nathmo/velion_lightboard_pcb/velion_lightboard_pcb (Mouser).xlsx

Reference | Qty | Value | DNP | Exclude from BOM | Exclude from Board | Datasheet | Original Part | Original Manufacturer | Matched Part Number | Part Match | Description | Qty | Selected Offers | Selected Distributor | Selected Distributor SKU | Selected Offers (Distributor Link) | Stock | Unit Price, $ | Total Quantity | Total Price
C0, C1, C2, C3, C4, C5, C6, C7, C8, C9, C10, C11, C12, C13, C14, C15, C16, C17, C18 | 19 | 100nF |  |  |  | ~ | 100nF |  | 1206B104K101CT | Selected | 1026 0.1 uF 100 V ±10 % Tolerance X7R SMT Multilayer Ceramic Capacitor | 76 | Mouser 791-1206B104K101CT (https://octopart.com/opatz8j6/a1) | Mouser | 791-1206B104K101CT (https://octopart.com/opatz8j6/a1) | https://octopart.com/opatz8j6/a1 | 8900 | 0.037 | 76 | 2.81
C19, C20, C21 | 3 | 1nF |  |  |  | ~ | 1nF |  | 1206B102K101CT | Selected | Multilayer Ceramic Capacitor, 1000 Pf, 10%, X7R, 100 V, 1206 | 12 | Mouser 791-1206B102K101CT (https://octopart.com/opatz8j6/a1) | Mouser | 791-1206B102K101CT (https://octopart.com/opatz8j6/a1) | https://octopart.com/opatz8j6/a1 | 56940 | 0.048 | 12 | 0.576
D0 | 1 | US1M |  |  |  | https://www.diodes.com/assets/Datasheets/ds16008.pdf | US1M |  | S1M-13-F | Selected | Rectifier Standard Recovery Gpp Sma 1.0A 1000V Rohs 5K Rohs Compliant: Yes | 4 | Mouser 621-S1M-F (https://octopart.com/opatz8j6/a1) | Mouser | 621-S1M-F (https://octopart.com/opatz8j6/a1) | https://octopart.com/opatz8j6/a1 | 300733 | 0.19 | 4 | 0.76
D2, D3, D6, D7, D9, D10 | 6 | RB551V-30-HF |  |  |  | ~ | RB551V-30-HF |  | RB551V-30-HF | Selected | Rectifier Diode, Schottky, 1 Phase, 1 Element, 0.5A, 30V V(RRM), Silicon | 24 | Mouser 750-RB551V-30-HF (https://octopart.com/opatz8j6/a1) | Mouser | 750-RB551V-30-HF (https://octopart.com/opatz8j6/a1) | https://octopart.com/opatz8j6/a1 | 3602 | 0.283 | 24 | 6.79
D4, D5, D8, D11, D12, D13 | 6 | D |  |  |  | ~ | D |  | S1M-13-F | Selected | Rectifier Standard Recovery Gpp Sma 1.0A 1000V Rohs 5K Rohs Compliant: Yes | 24 | Mouser 621-S1M-F (https://octopart.com/opatz8j6/a1) | Mouser | 621-S1M-F (https://octopart.com/opatz8j6/a1) | https://octopart.com/opatz8j6/a1 | 300733 | 0.111 | 24 | 2.66
Q0, Q5, Q6, Q11, Q12, Q17, Q18, Q19 | 8 | NMOS |  |  |  | ~ | NMOS |  | IRFML8244TRPBF | Selected | MOSFET N-CH 25V 5.8A SOT23 N-Channel 25 V 5.8A (Ta) 1.25W (Ta) Surface Mount SOT-23 | 32 | Mouser 942-IRFML8244TRPBF (https://octopart.com/opatz8j6/a1) | Mouser | 942-IRFML8244TRPBF (https://octopart.com/opatz8j6/a1) | https://octopart.com/opatz8j6/a1 | 1868 | 0.14 | 32 | 4.48
Q1, Q2, Q3, Q4, Q7, Q8, Q9, Q10, Q13, Q14, Q15, Q16 | 12 | BSS123-7-F |  |  |  | ~ | BSS123-7-F |  | BSS123-7-F | Selected | Transistor: N-MOSFET; unipolar; 100V; 170mA; 6ohm; 300mW; -55+150 deg.C; SMD; SOT23 | 48 | Mouser 621-BSS123-F (https://octopart.com/opatz8j6/a1) | Mouser | 621-BSS123-F (https://octopart.com/opatz8j6/a1) | https://octopart.com/opatz8j6/a1 | 87940 | 0.139 | 48 | 6.67
R1, R13, R15, R26, R27, R36, R38, R45 | 8 | 0.001 R |  |  |  | ~ | 0.001 R |  | CSNL2512FT1L00 | Selected | Res Metal Foil 2512 0.001 Ohm 1% 2W ±50ppm/C Pad SMD Automotive T/R | 32 | Mouser 708-CSNL2512FT1L00 (https://octopart.com/opatz8j6/a1) | Mouser | 708-CSNL2512FT1L00 (https://octopart.com/opatz8j6/a1) | https://octopart.com/opatz8j6/a1 | 19878 | 0.361 | 32 | 11.55
U2 | 1 | MCP23017_SO |  |  |  | https://ww1.microchip.com/downloads/aemDocuments/documents/APID/ProductDocuments/DataSheets/MCP23017-Data-Sheet-DS20001952.pdf | MCP23017_SO |  | MCP23017T-E/SO | Selected | MCP23017 Series 5.5 V 1.7 MHz SMT 16-Bit I2C I/O Expander - SOIC-28 | 4 | Mouser 579-MCP23017T-E/SO (https://octopart.com/opatz8j6/a1) | Mouser | 579-MCP23017T-E/SO (https://octopart.com/opatz8j6/a1) | https://octopart.com/opatz8j6/a1 | 12638 | 1.62 | 4 | 6.48
U3, U4, U9, U11, U12, U13 | 6 | LM2104DR |  |  |  |  | LM2104DR |  | LM2104DR | Selected | "107-V, 0.5-A/0.8-A HALF-BRIDGE G" Half-Bridge Gate Driver IC Inverting 8-SOIC | 24 | Mouser 595-LM2104DR (https://octopart.com/opatz8j6/a1) | Mouser | 595-LM2104DR (https://octopart.com/opatz8j6/a1) | https://octopart.com/opatz8j6/a1 | 3412 | 0.566 | 24 | 13.58
U5, U7, U10 | 3 | MCP6L01x-xOT |  |  |  | http://ww1.microchip.com/downloads/en/devicedoc/22140b.pdf | MCP6L01x-xOT |  | MCP6L01T-E/OT | Selected | IC OPAMP GP 1 CIRCUIT SOT23-5 General Purpose Amplifier 1 Circuit Rail-to-Rail SOT-23-5 | 12 | Mouser 579-MCP6L01T-E/OT (https://octopart.com/opatz8j6/a1) | Mouser | 579-MCP6L01T-E/OT (https://octopart.com/opatz8j6/a1) | https://octopart.com/opatz8j6/a1 | 131977 | 0.32 | 12 | 3.84
U6, U14 | 2 | ADS1115IDGS |  |  |  | http://www.ti.com/lit/ds/symlink/ads1113.pdf | ADS1115IDGS |  | ADS1115IDGST | Selected | Quad Channel Single ADC Delta-Sigma 860sps 16-bit Serial 10-Pin VSSOP T/R | 8 | Mouser 595-ADS1115IDGST (https://octopart.com/opatz8j6/a1) | Mouser | 595-ADS1115IDGST (https://octopart.com/opatz8j6/a1) | https://octopart.com/opatz8j6/a1 | 4418 | 4.83 | 10 | 48.3
U8 | 1 | TJA1051T-3 |  |  |  | http://www.nxp.com/docs/en/data-sheet/TJA1051.pdf | TJA1051T-3 |  | TJA1051T/3/2Z | Selected | CAN Interface, CAN Transceiver, I2C, 5 Mbps, 4.5 V, 5.5 V, SOIC, 8 Pins | 4 | Mouser 771-TJA1051T/3/2Z (https://octopart.com/opatz8j6/a1) | Mouser | 771-TJA1051T/3/2Z (https://octopart.com/opatz8j6/a1) | https://octopart.com/opatz8j6/a1 | 3444 | 1.22 | 4 | 4.88
