nathmo/velion_lightboard_pcb/velion_lightboard_pcb.step

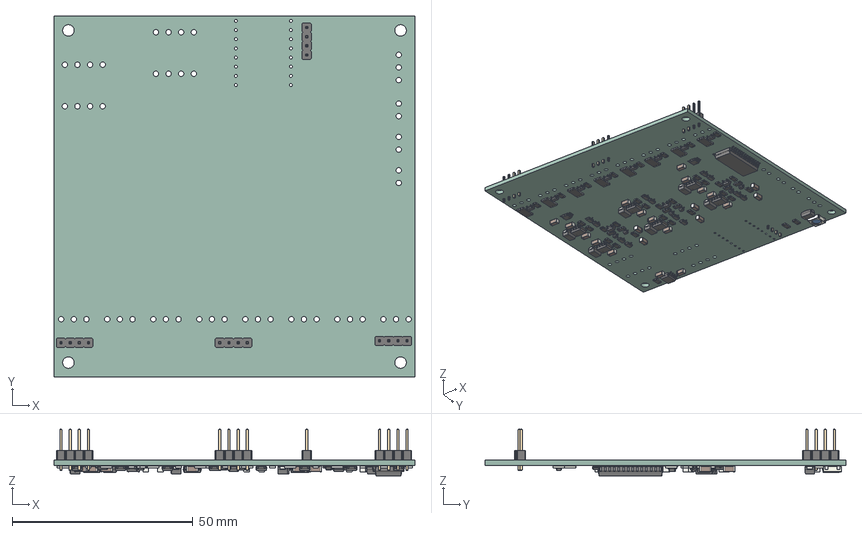
[picture p1: CAD file, 2026-01-05]
velion_lightboard_pcb.step
100.0 x 100.0 x 13.0 mm
PinHeader_1x04_P2.54mm_Vertical x 4
TSSOP-10_3x3mm_P0.5mm x 2
D_SOD-323 x 6
C_1206_3216Metric x 22
SOT-23 x 8
TSOT-23 x 12
SOT-23-5 x 3
D_SMA x 7
R_1206_3216Metric x 38
SO-8_3.9x4.9mm_P1.27mm x 6
R_2512_6332Metric x 8
SOIC-8_3.9x4.9mm_P1.27mm
SOIC-28W_7.5x17.9mm_P1.27mm
LED_WS2812B_PLCC4_5.0x5.0mm_P3.2mm
velion_lightboard_pcb_PCB
