nathmo/velion_lightboard_pcb/exports/velion_lightboard_pcb_schematic.pdf

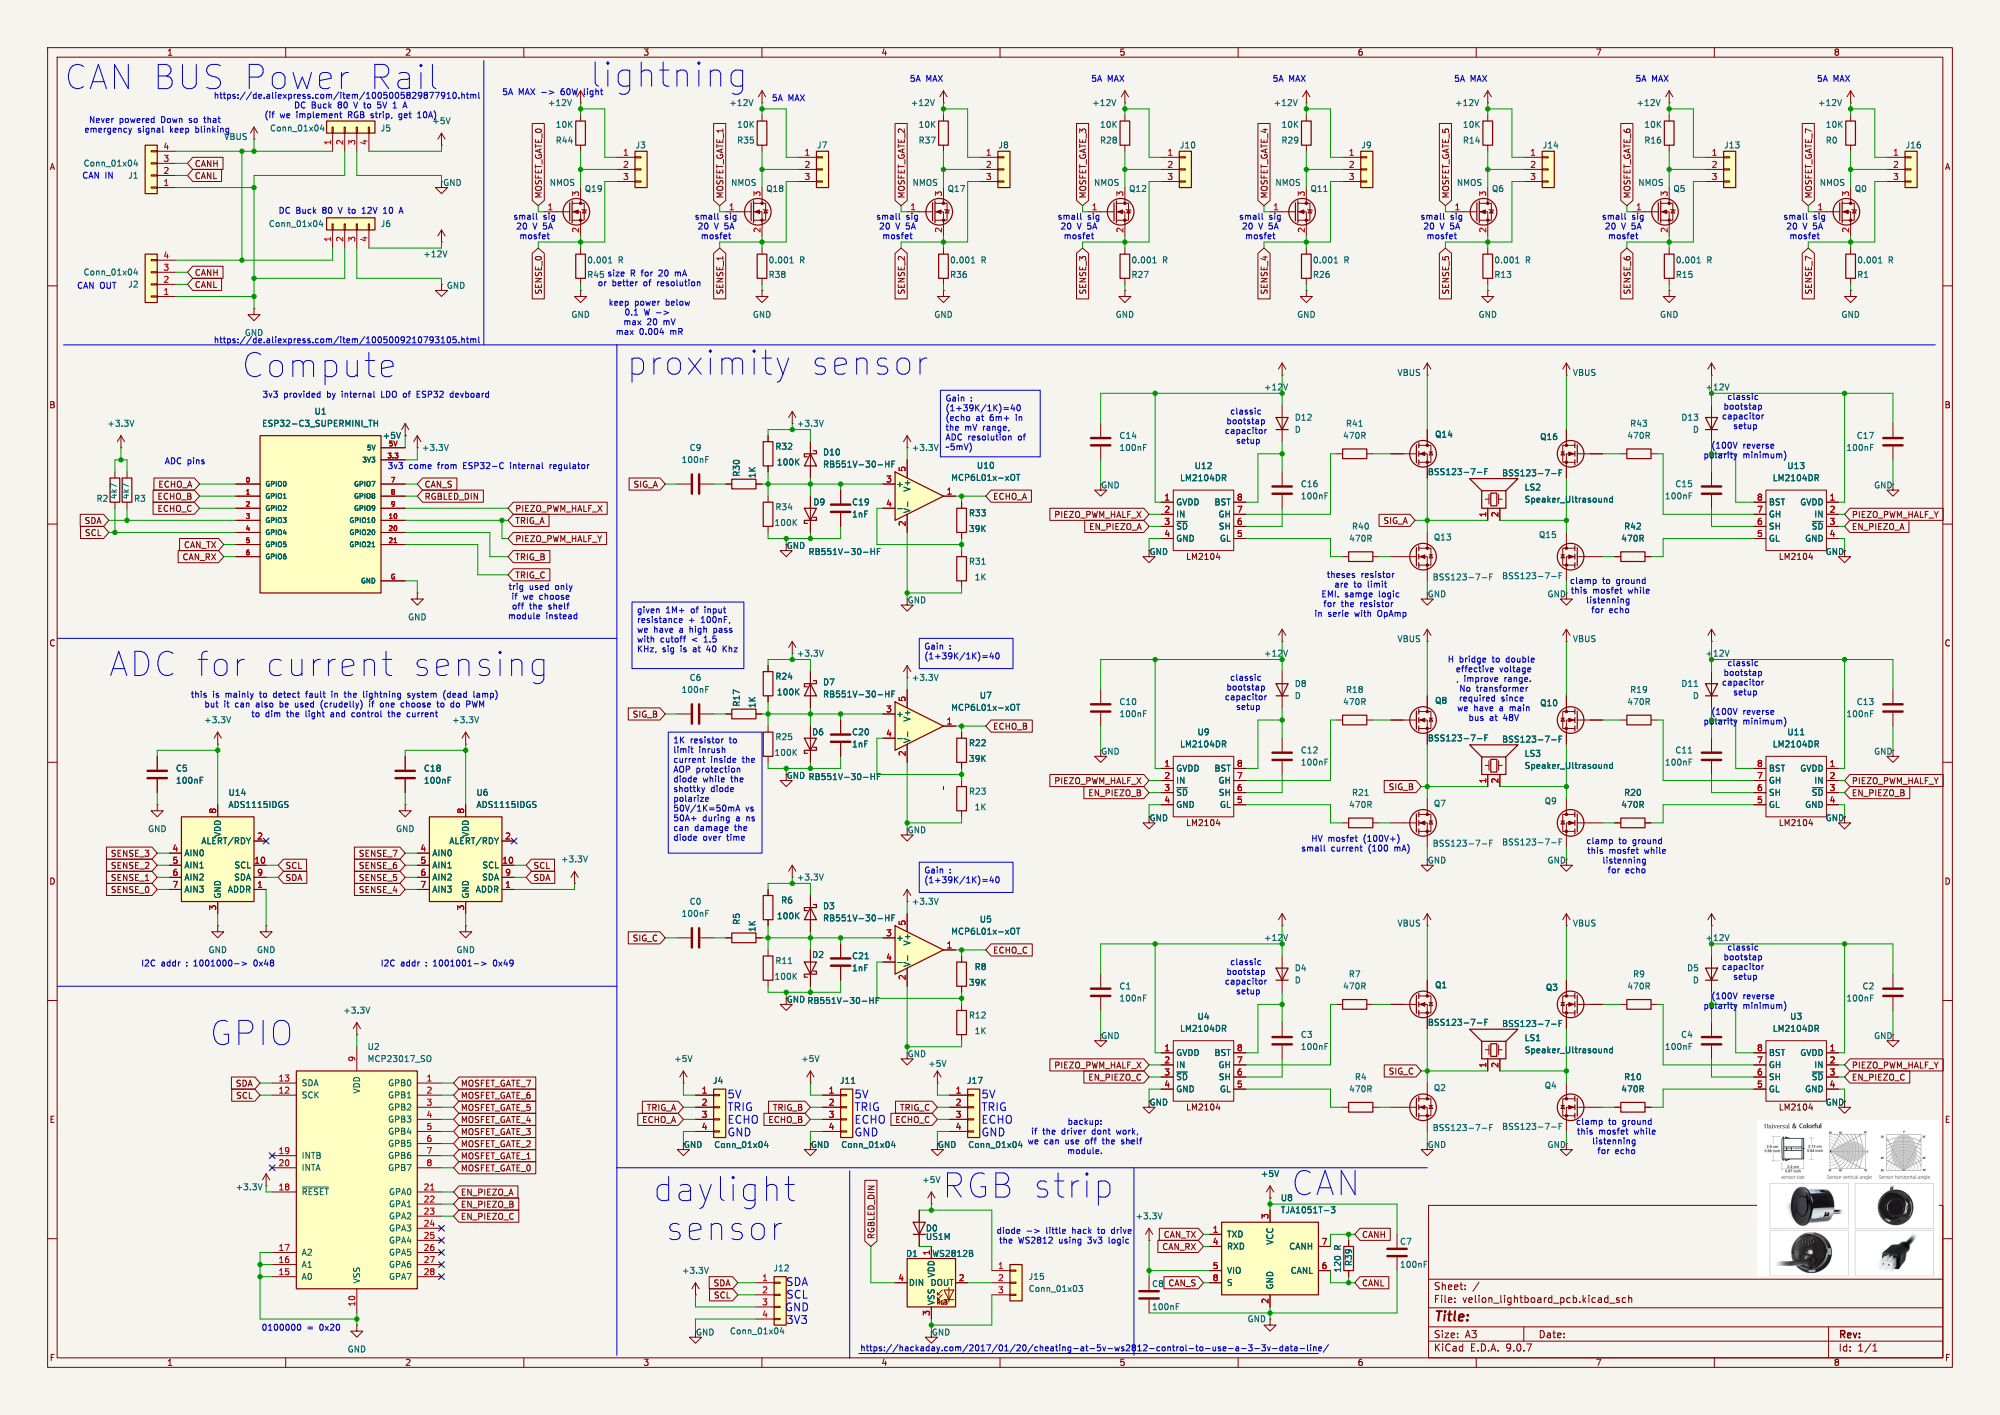
[picture p2: page 1]

CAN BUS Power Rail

4 Conn_01x04 J5
ADC pins CAN IN

keep power below
0.1 W -> max 20 mV max 0.004 mR

https://de.aliexpress.com/item/1005009210793105.html

TRIG_C
trig used only
if we choose
off the shelf module instead

theses resistor are to limit EMI. samge logic

for the resistor
in serie with OpAmp

, improve range. No transformer

limit inrush
current inside the AOP protection

3 ALERT/RDY 2 SCL 10 SDA 9 ADDR 1 C18

3 ALERT/RDY 2 SCL 10 SDA 9 ADDR 1 U14 ADS1115IDGS

3 ALERT/RDY 2 SCL 10 SDA 9 ADDR 1 U6ADS1115IDGS GND

3 ALERT/RDY 2 SCL 10 SDA 9 ADDR 1 U5 MCP6L01x-xOT V+

https://hackaday.com/2017/01/20/cheating-at-5v-ws2812-control-to-use-a-3-3v-data-line/
