nathmo/velion_lightboard_pcb/exports/velion_lightboard_pcb_layout.pdf

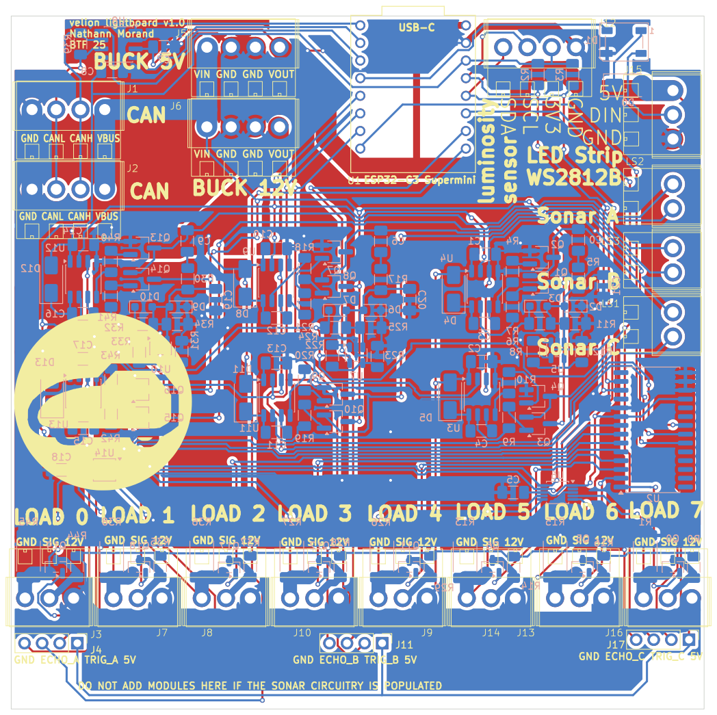
[picture p3: page 1]

GND CANL CANH VBUSCAN
