nathmo/velion_lightboard_pcb/velion_lightboard_pcb.kicad_pcb

## KiCad design velion_lightboard_pcb.kicad_pcb (2026-01-05)

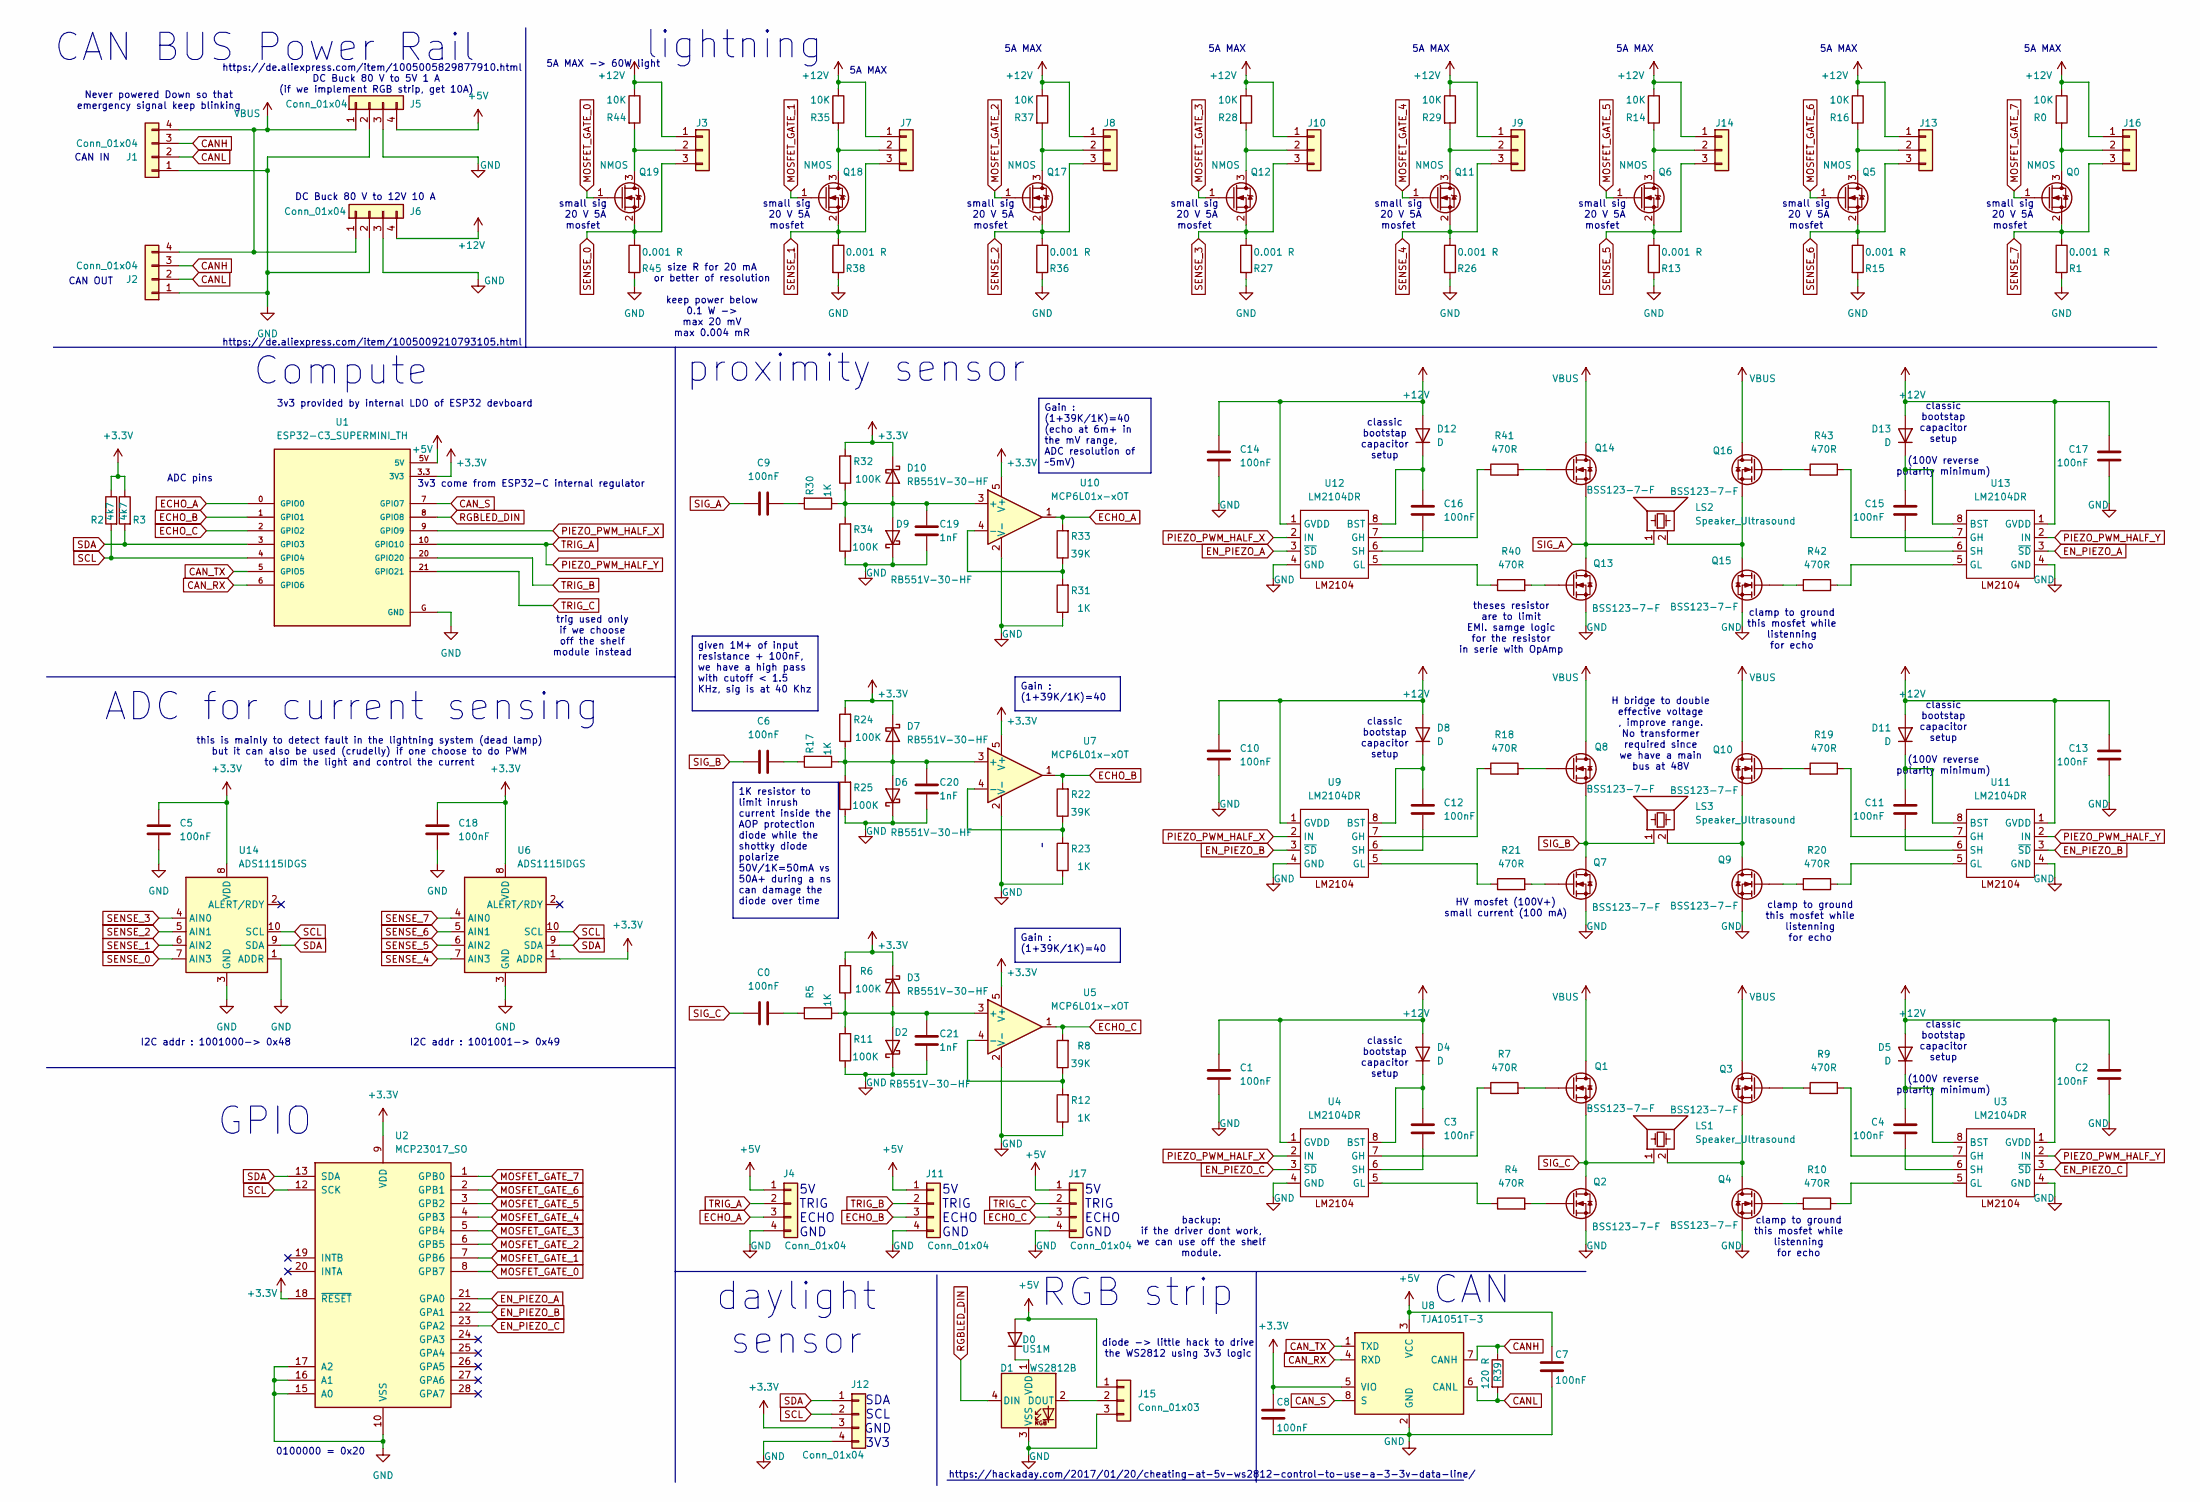
[picture p4: schematic velion_lightboard_pcb.kicad_sch]

Parts:
C0, C1, C2, C3, C4, C5, C6, C7, C8, C9, C10, C11, C12, C13, C14, C15, C16, C17, C18: 100nF; C_1206_3216Metric_Pad1.33x1.80mm_HandSolder
C19, C20, C21: 1nF; C_1206_3216Metric_Pad1.33x1.80mm_HandSolder
D0: US1M; D_SMA
D1: WS2812B; LED_WS2812B_PLCC4_5.0x5.0mm_P3.2mm
D2, D3, D6, D7, D9, D10: RB551V-30-HF; D_SOD-323_HandSoldering
D4, D5, D8, D11, D12, D13: D; D_SMA
J1, J2, J5, J6, J12: Conn_01x04; 15EDG-4P
J3, J7, J8, J9, J10, J13, J14, J15, J16: Conn_01x03; 15EDG-3P
J4, J11, J17: Conn_01x04; PinHeader_1x04_P2.54mm_Vertical
LS1, LS2, LS3: Speaker_Ultrasound; 15EDG-2P
Q0, Q5, Q6, Q11, Q12, Q17, Q18, Q19: NMOS; SOT-23
Q1, Q2, Q3, Q4, Q7, Q8, Q9, Q10, Q13, Q14, Q15, Q16: BSS123-7-F; BSS123_TSOT-23_HandSoldering
R0, R14, R16, R28, R29, R35, R37, R44: 10K; R_1206_3216Metric_Pad1.30x1.75mm_HandSolder
R1, R13, R15, R26, R27, R36, R38, R45: 0.001 R; R_2512_6332Metric_Pad1.40x3.35mm_HandSolder
R2, R3: 4k7; R_1206_3216Metric_Pad1.30x1.75mm_HandSolder
R4, R7, R9, R10, R18, R19, R20, R21, R40, R41, R42, R43: 470R; R_1206_3216Metric_Pad1.30x1.75mm_HandSolder
R5, R12, R17, R23, R30, R31: 1K; R_1206_3216Metric_Pad1.30x1.75mm_HandSolder
R6, R11, R24, R25, R32, R34: 100K; R_1206_3216Metric_Pad1.30x1.75mm_HandSolder
R8, R22, R33: 39K; R_1206_3216Metric_Pad1.30x1.75mm_HandSolder
R39: 120 R; R_1206_3216Metric_Pad1.30x1.75mm_HandSolder
U1: ESP32-C3_SUPERMINI_TH; MODULE_ESP32-C3_SUPERMINI_TH
U2: MCP23017_SO; SOIC-28W_7.5x17.9mm_P1.27mm
U3, U4, U9, U11, U12, U13: LM2104DR; SO-8_3.9x4.9mm_P1.27mm
U5, U7, U10: MCP6L01x-xOT; SOT-23-5
U6, U14: ADS1115IDGS; VSSOP-10_3x3mm_P0.5mm
U8: TJA1051T-3; SOIC-8_3.9x4.9mm_P1.27mm

Connections:
+3.3V: C5.1, C8.1, C18.1, D3.1 (K), D7.1 (K), D10.1 (K), J12.3, R2.1, R3.1, R6.2, R24.2, R32.2, U1.3.3 (3V3), U2.9 (VDD), U2.18 (~RESET), U5.5 (V+), U6.1 (ADDR), U6.8 (VDD), U7.5 (V+), U8.5 (VIO), U10.5 (V+), U14.8 (VDD)
+5V: C7.1, D0.2 (A), J4.1, J5.4, J11.1, J15.1, J17.1, U1.5V, U8.3 (VCC)
+12V: C1.1, C2.1, C10.1, C13.1, C14.1, C17.1, D4.2 (A), D5.2 (A), D8.2 (A), D11.2 (A), D12.2 (A), D13.2 (A), J3.1, J6.4, J7.1, J8.1, J9.1, J10.1, J13.1, J14.1, J16.1, R0.1, R14.1, R16.1, R28.1, R29.1, R35.1, R37.1, R44.1, U3.1 (GVDD), U4.1 (GVDD), U9.1 (GVDD), U11.1 (GVDD), U12.1 (GVDD), U13.1 (GVDD)
CANH: J1.3, J2.3, R39.1, U8.7 (CANH)
CANL: J1.2, J2.2, R39.2, U8.6 (CANL)
CAN_RX: U1.6 (GPIO6), U8.4 (RXD)
CAN_S: U1.7 (GPIO7), U8.8 (S)
CAN_TX: U1.5 (GPIO5), U8.1 (TXD)
ECHO_A: J4.3, R33.2, U1.0 (GPIO0), U10.1
ECHO_B: J11.3, R22.2, U1.1 (GPIO1), U7.1
ECHO_C: J17.3, R8.2, U1.2 (GPIO2), U5.1
EN_PIEZO_A: U2.21 (GPA0), U12.3 (~SD), U13.3 (~SD)
EN_PIEZO_B: U2.22 (GPA1), U9.3 (~SD), U11.3 (~SD)
EN_PIEZO_C: U2.23 (GPA2), U3.3 (~SD), U4.3 (~SD)
GND: C1.2, C2.2, C5.2, C7.2, C8.2, C10.2, C13.2, C14.2, C17.2, C18.2, C19.1, C20.1, C21.1, D1.3 (VSS), D2.1 (K), D6.1 (K), D9.1 (K), J1.1, J2.1, J4.4, J5.2, J5.3, J6.2, J6.3, J11.4, J12.4, J15.3, J17.4, Q2.S, Q4.S, Q7.S, Q9.S, Q13.S, Q15.S, R1.2, R11.1, R12.1, R13.2, R15.2, R23.1, R25.1, R26.2, R27.2, R31.1, R34.1, R36.2, R38.2, R45.2, U1.G (GND), U2.10 (VSS), U2.15 (A0), U2.16 (A1), U2.17 (A2), U3.4 (GND), U4.4 (GND), U5.2 (V-), U6.3 (GND), U7.2 (V-), U8.2 (GND), U9.4 (GND), U10.2 (V-), U11.4 (GND), U12.4 (GND), U13.4 (GND), U14.1 (ADDR), U14.3 (GND)
MOSFET_GATE_0: Q19.1 (G), U2.8 (GPB7)
MOSFET_GATE_1: Q18.1 (G), U2.7 (GPB6)
MOSFET_GATE_2: Q17.1 (G), U2.6 (GPB5)
MOSFET_GATE_3: Q12.1 (G), U2.5 (GPB4)
MOSFET_GATE_4: Q11.1 (G), U2.4 (GPB3)
MOSFET_GATE_5: Q6.1 (G), U2.3 (GPB2)
MOSFET_GATE_6: Q5.1 (G), U2.2 (GPB1)
MOSFET_GATE_7: Q0.1 (G), U2.1 (GPB0)
unnamed: C0.1, R5.2
unnamed: C6.1, R17.2
unnamed: C9.1, R30.2
unnamed: D0.1 (K), D1.1 (VDD)
unnamed: D1.2 (DOUT), J15.2
unnamed: C21.2, D2.2 (A), D3.2 (A), R5.1, R6.1, R11.2, U5.3 (+)
unnamed: C3.1, D4.1 (K), U4.8 (BST)
unnamed: C4.1, D5.1 (K), U3.8 (BST)
unnamed: C20.2, D6.2 (A), D7.2 (A), R17.1, R24.1, R25.2, U7.3 (+)
unnamed: C12.1, D8.1 (K), U9.8 (BST)
unnamed: C19.2, D9.2 (A), D10.2 (A), R30.1, R32.1, R34.2, U10.3 (+)
unnamed: C11.1, D11.1 (K), U11.8 (BST)
unnamed: C16.1, D12.1 (K), U12.8 (BST)
unnamed: C15.1, D13.1 (K), U13.8 (BST)
unnamed: J3.2, Q19.3 (D), R44.2
unnamed: J7.2, Q18.3 (D), R35.2
unnamed: J8.2, Q17.3 (D), R37.2
unnamed: J9.2, Q11.3 (D), R29.2
unnamed: J10.2, Q12.3 (D), R28.2
unnamed: J13.2, Q5.3 (D), R16.2
unnamed: J14.2, Q6.3 (D), R14.2
unnamed: J16.2, Q0.3 (D), R0.2
unnamed: LS1.2, Q3.S, Q4.D
unnamed: LS2.2, Q15.D, Q16.S
unnamed: LS3.2, Q9.D, Q10.S
unnamed: Q1.G, R7.2
unnamed: Q2.G, R4.2
unnamed: Q3.G, R9.2
unnamed: Q4.G, R10.2
unnamed: Q7.G, R21.2
unnamed: Q8.G, R18.2
unnamed: Q9.G, R20.2
unnamed: Q10.G, R19.2
unnamed: Q13.G, R40.2
unnamed: Q14.G, R41.2
unnamed: Q15.G, R42.2
unnamed: Q16.G, R43.2
unnamed: R9.1, U3.7 (GH)
unnamed: R10.1, U3.5 (GL)
unnamed: C4.2, U3.6 (SH)
unnamed: R7.1, U4.7 (GH)
unnamed: R4.1, U4.5 (GL)
unnamed: C3.2, U4.6 (SH)
unnamed: R8.1, R12.2, U5.4 (-)
unnamed: R22.1, R23.2, U7.4 (-)
unnamed: R18.1, U9.7 (GH)
unnamed: R21.1, U9.5 (GL)
unnamed: C12.2, U9.6 (SH)
unnamed: R31.2, R33.1, U10.4 (-)
unnamed: R19.1, U11.7 (GH)
unnamed: R20.1, U11.5 (GL)
unnamed: C11.2, U11.6 (SH)
unnamed: R41.1, U12.7 (GH)
unnamed: R40.1, U12.5 (GL)
unnamed: C16.2, U12.6 (SH)
unnamed: R43.1, U13.7 (GH)
unnamed: R42.1, U13.5 (GL)
unnamed: C15.2, U13.6 (SH)
PIEZO_PWM_HALF_X: U1.9 (GPIO9), U4.2 (IN), U9.2 (IN), U12.2 (IN)
PIEZO_PWM_HALF_Y: J4.2, U1.10 (GPIO10), U3.2 (IN), U11.2 (IN), U13.2 (IN)
RGBLED_DIN: D1.4 (DIN), U1.8 (GPIO8)
SCL: J12.2, R2.2, U1.4 (GPIO4), U2.12 (SCK), U6.10 (SCL), U14.10 (SCL)
SDA: J12.1, R3.2, U1.3 (GPIO3), U2.13 (SDA), U6.9 (SDA), U14.9 (SDA)
SENSE_0: J3.3, Q19.2 (S), R45.1, U14.7 (AIN3)
SENSE_1: J7.3, Q18.2 (S), R38.1, U14.6 (AIN2)
SENSE_2: J8.3, Q17.2 (S), R36.1, U14.5 (AIN1)
SENSE_3: J10.3, Q12.2 (S), R27.1, U14.4 (AIN0)
SENSE_4: J9.3, Q11.2 (S), R26.1, U6.7 (AIN3)
SENSE_5: J14.3, Q6.2 (S), R13.1, U6.6 (AIN2)
SENSE_6: J13.3, Q5.2 (S), R15.1, U6.5 (AIN1)
SENSE_7: J16.3, Q0.2 (S), R1.1, U6.4 (AIN0)
SIG_A: C9.2, LS2.1, Q13.D, Q14.S
SIG_B: C6.2, LS3.1, Q7.D, Q8.S
SIG_C: C0.2, LS1.1, Q1.S, Q2.D
TRIG_B: J11.2, U1.20 (GPIO20)
TRIG_C: J17.2, U1.21 (GPIO21)
VBUS: J1.4, J2.4, J5.1, J6.1, Q1.D, Q3.D, Q8.D, Q10.D, Q14.D, Q16.D

Notes on the sheet:
5A MAX
small sig 20 V 5A mosfet
CAN OUT
classic bootstap capacitor setup
Compute
I2C addr : 1001001-> 0x49
GPIO
RGB strip
clamp to ground this mosfet while listenning for echo
CAN IN
this is mainly to detect fault in the lightning system (dead lamp) but it can also be used (crudelly) if one choose to do PWM to dim the light and control the current
classic bootstap capacitor setup (100V reverse polarity minimum)
lightning
0100000 = 0x20
Never powered Down so that emergency signal keep blinking
5V TRIG ECHO GND
https://de.aliexpress.com/item/1005009210793105.html
trig used only if we choose off the shelf module instead
ADC pins
proximity sensor
theses resistor are to limit EMI. samge logic for the resistor in serie with OpAmp
DC Buck 80 V to 12V 10 A
3v3 provided by internal LDO of ESP32 devboard
backup: if the driver dont work, we can use off the shelf module.
daylight sensor
size R for 20 mA or better of resolution keep power below 0.1 W -> max 20 mV max 0.004 mR
DC Buck 80 V to 5V 1 A (if we implement RGB strip, get 10A)
ADC for current sensing
I2C addr : 1001000-> 0x48
H bridge to double effective voltage , improve range. No transformer required since we have a main bus at 48V
5A MAX -> 60W light
CAN
diode -> little hack to drive the WS2812 using 3v3 logic
https://de.aliexpress.com/item/1005005829877910.html
CAN BUS Power Rail
https://hackaday.com/2017/01/20/cheating-at-5v-ws2812-control-to-use-a-3-3v-data-line/
3v3 come from ESP32-C internal regulator
SDA SCL GND 3V3
HV mosfet (100V+) small current (100 mA)
Gain : (1+39K/1K)=40
given 1M+ of input resistance + 100nF, we have a high pass with cutoff < 1.5 KHz, sig is at 40 Khz
Gain : (1+39K/1K)=40 (echo at 6m+ in the mV range, ADC resolution of ~5mV)
1K resistor to limit inrush current inside the AOP protection diode while the shottky diode polarize 50V/1K=50mA vs 50A+ during a ns can damage the diode over time

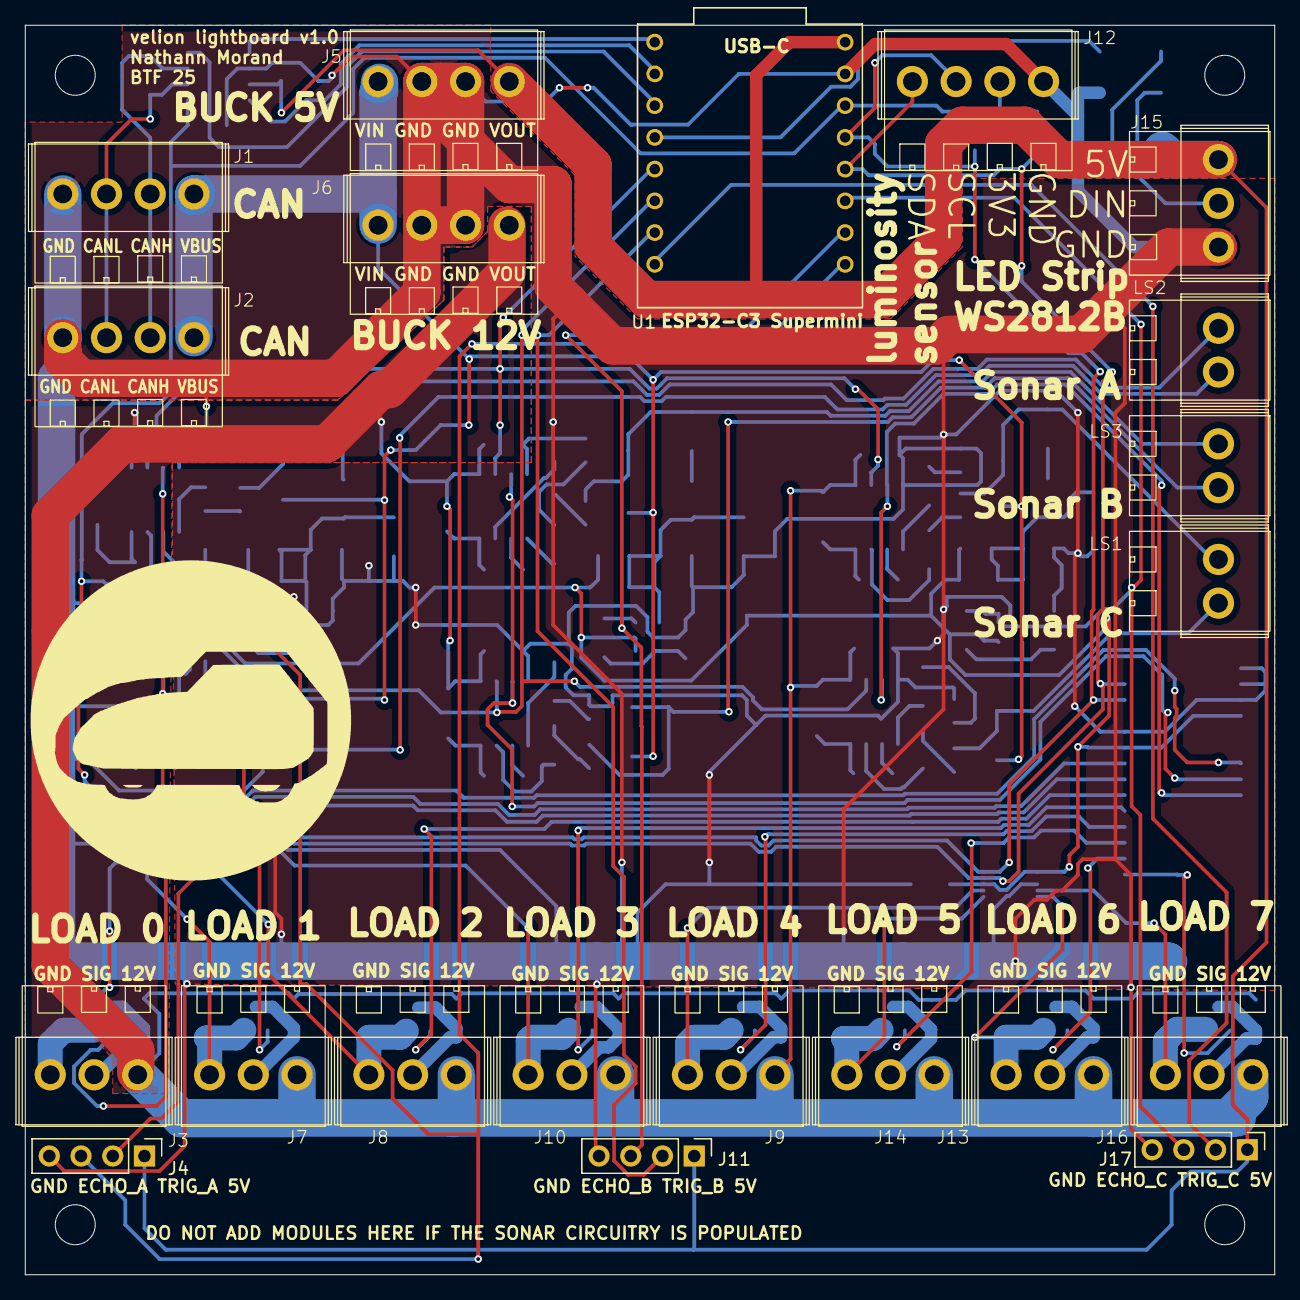
[picture p5: board velion_lightboard_pcb.kicad_pcb from above]

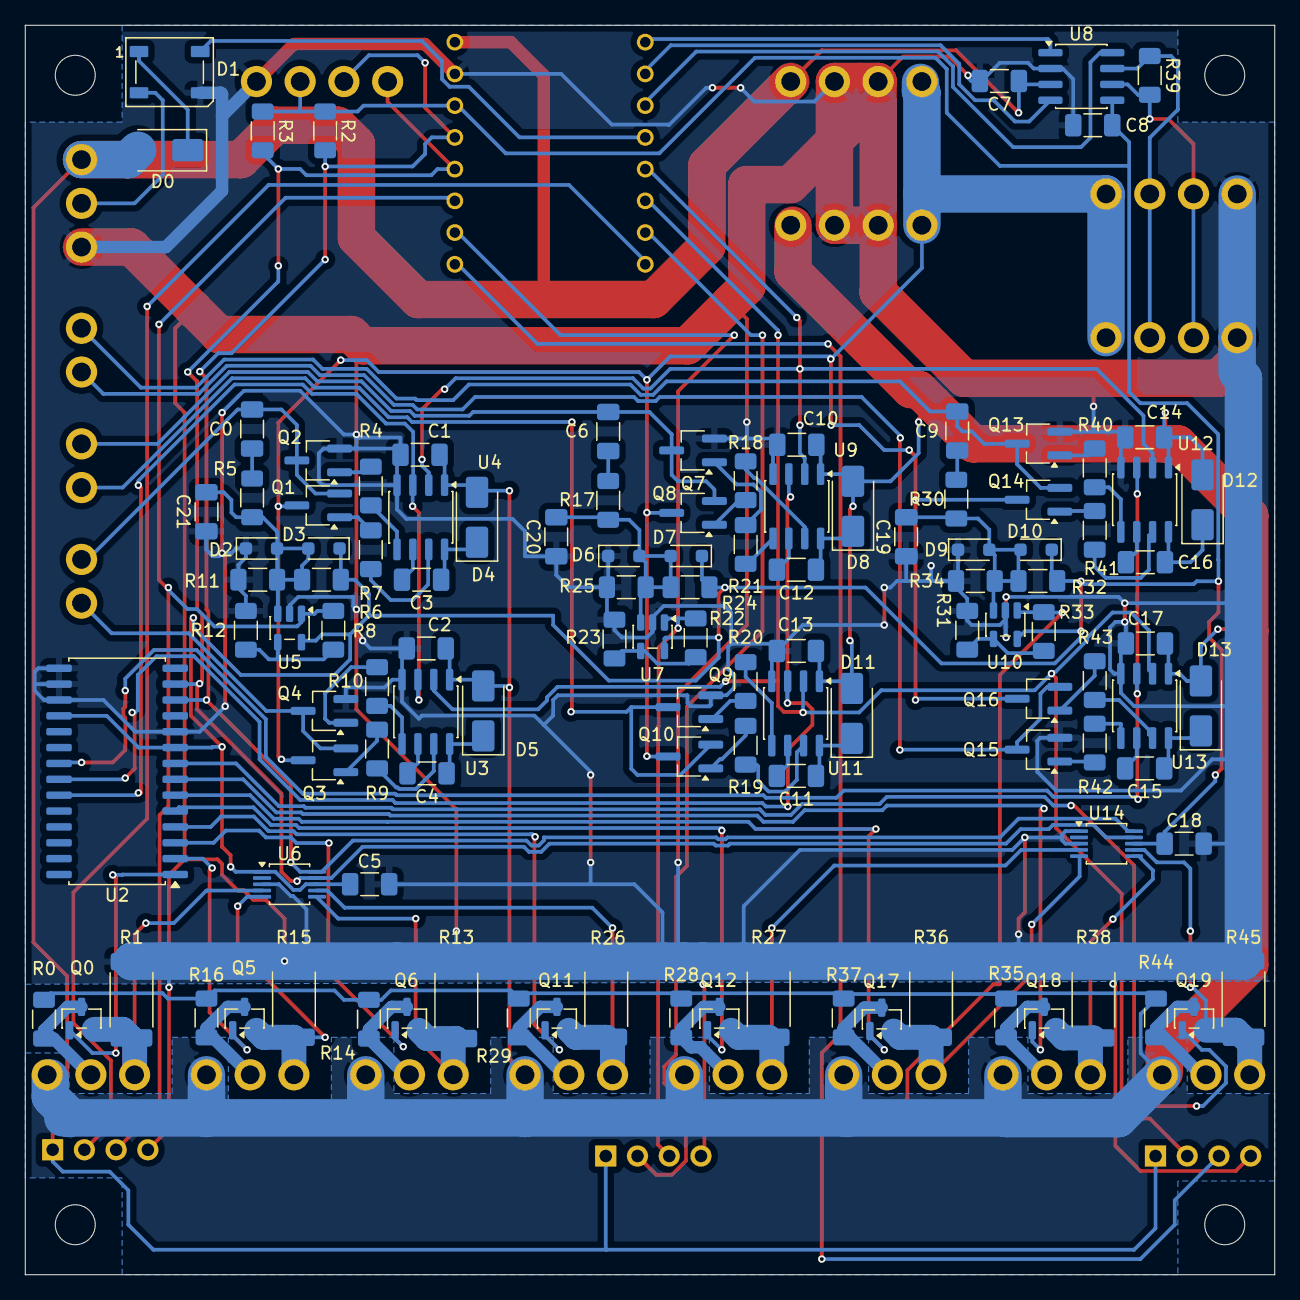
[picture p6: board velion_lightboard_pcb.kicad_pcb from below]

Board: 2 copper layers, 100.0 x 100.0 mm, 140 parts (115 on the bottom side), 100 nets.

Other parts of the board:
TR1, TR2, TR3, TR4: MountingHole_3.2mm_M3
