nathmo/velion_lightboard_pcb/(commit log)

2025-12-27 added library
    [MainBoard.kicad_pcb, velion_lightboard_pcb.kicad_pcb, velion_lightboard_pcb.kicad_sch]
2025-12-27 removed stray file
    [MainBoard.kicad_pcb]
2025-12-28 designing relay board
    [velion_lightboard_pcb.kicad_sch]
2025-12-28 rotated image
    [velion_lightboard_pcb.kicad_sch]
2025-12-28 Auto-export KiCad PDFs
2025-12-29 switched MCU, implemented led driver, TODO : rangerfinder
    [ESP32-C3_SUPERMINI_TH.step, velion_lightboard_pcb.kicad_sch]
2025-12-30 Implemented piezo sonar driver
    [velion_lightboard_pcb.kicad_sch]
2025-12-30 implemented Analog stage for piezzo sonar
    [velion_lightboard_pcb.kicad_sch]
2025-12-31 layaing out the components
    [velion_lightboard_pcb.kicad_pcb, velion_lightboard_pcb.kicad_sch]
2026-01-01 routed the PCB, need review
    [velion_lightboard_pcb.kicad_pcb, velion_lightboard_pcb.kicad_sch]
2026-01-05 generated fab file, added capacitor for low pass/antialiasing in Sonar
    [velion_lightboard_pcb-B_Cu.gbr, velion_lightboard_pcb-B_Mask.gbr, velion_lightboard_pcb-B_Paste.gbr, velion_lightboard_pcb-B_Silkscreen.gbr, velion_lightboard_pcb-Edge_Cuts.gbr, velion_lightboard_pcb-F_Cu.gbr, velion_lightboard_pcb-F_Mask.gbr, velion_lightboard_pcb-F_Paste.gbr]
2026-01-05 replaced the light sensor pin header by a standard bornier
    [velion_lightboard_pcb-B_Cu.gbr, velion_lightboard_pcb-B_Mask.gbr, velion_lightboard_pcb-B_Paste.gbr, velion_lightboard_pcb-B_Silkscreen.gbr, velion_lightboard_pcb-Edge_Cuts.gbr, velion_lightboard_pcb-F_Cu.gbr, velion_lightboard_pcb-F_Mask.gbr, velion_lightboard_pcb-F_Paste.gbr]
2026-01-05 adding BOM for mouser
    [velion_lightboard_pcb (Mouser).xlsx, velion_lightboard_pcb.kicad_pcb, velion_lightboard_pcb.kicad_sch]
